diyaudioby/psl-3604/transformers/th-trans-psl-3604.JPG

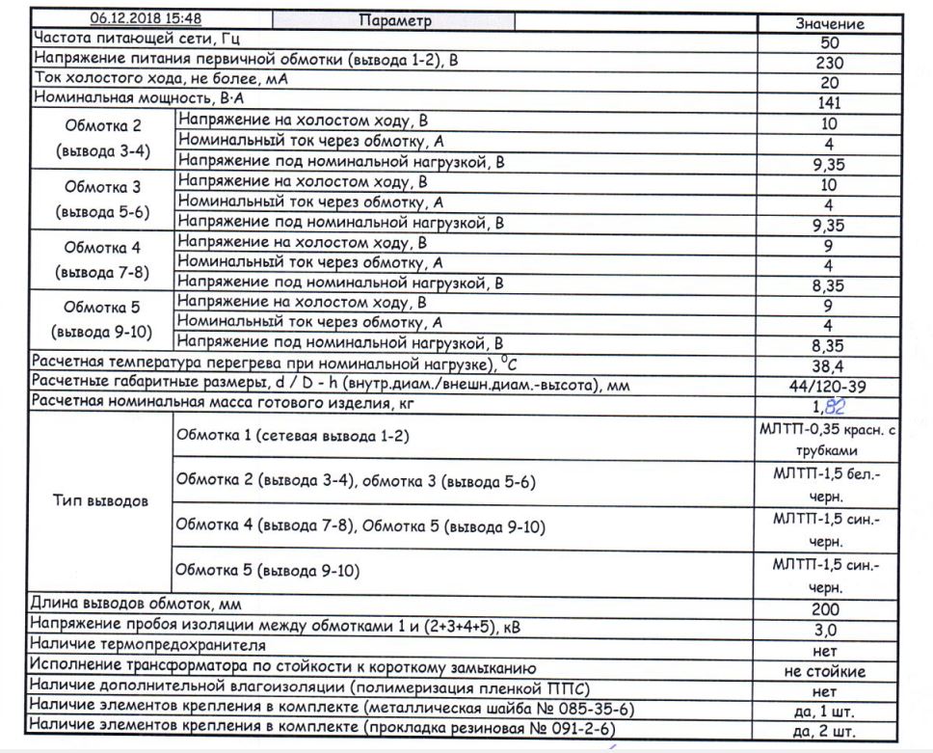
transformers/th-trans-psl-3604.JPG
