diyaudioby/psl-3604/bom/psl-3604-bom.xlsx

Таблица заказа комплектации PSL-3604 | ФИО |  |  | Комплектация | 1700.42
1. Сохранить таблицу (Файл - Скачать - Microsoft Excel) | Адрес доставки |  |  | Доставка
2. Проставить нужное количество деталек (столбец Е) либо удалить | Пункт выдачи заказа CDEK
3. Заполнить контактные данные | Телефон |  |  | Итого | 1700.42
4. Отправить на diyaudioby@gmail.com | Email
Позиция | Номинал | Доп. инфо | Кол-во | Цена, рос. руб | Сумма
Платы, трансформатор, корпус
Комплект плат |  |  | 1 | 700 | 700
Трансформатор |  |  | 1 |  |  | предзаказ - 1600р
Корпус Kradex Z2A |  |  | 1 |  |  | предзаказ - 400р
Конденсаторы SMD 0805
OUT: C33, C34 | 47p | NPO | 2
POW: C31 | 120p | NPO | 1
PAN: C2, C4 | 220p | NPO | 2
POW: C32, C39, C51 | 1n | NPO | 3
POW: C28, C29, C37, C38 | 2.2n | NPO | 4
OUT: C5 | 4.7n | X7R | 1
POW: C22 - C25, C35, C36, C40, C41, C42; PAN: C19; OUT: C14 | 10n | X7R | 11
OUT: C50 | 47n | X7R | 1
POW: C43 - C46; PAN: C1, C6, C9, C11 - C13, C15, C17, C18; OUT: C2, C6, C8, C15, C17 | 100n | X7R | 18
POW: C52; PAN: C3 | 1u | X7R | 2
Конденсаторы SMD 1206
OUT: C10 - C13 | 100n 100V | X7R 1210 | 4
Конденсаторы SMD танталовые
POW: C26, C27 | 1u 16V | Size A | 2
PAN: C8, C10, C14; OUT: C1, C3, C4, C7, C9, C16 | 22u 16V | Size B | 9
Конденсаторы электролитические выводные
POW: C4 - C9, C47, C48 | 47uF x 50V | d=6 | 8
POW: C1, C3 | 47uF x 100V | d=10 | 2
POW: C49 | 220uF x 25V | D=8 | 1
POW: C2 | 470uF x 35V | D=10 | 1
POW: C14, C19 | 1000uF x 35V | Samhwa SD (10*20) | 2
POW: C20 | 2200uF x 63V | Samhwa SD (18*31) | 1 | 40 | 40
POW: C21 | 3300uF x 50V | Samhwa SD (18*31) | 1 | 40 | 40
POW: C10 - C13, C15 - C18 | 10 000uF x 16V | Samhwa SD (16*31) | 8 | 40 | 320
Конденсаторы плёночные выводные
POW: C30 | 470n 63V | LS=5 (проверить) | 1
Резисторы SMD 0805 1% Yageo
POW: R68, R69; PAN: R41, R42 | 22R |  | 4
PAN: R29 | 49.9R |  | 1
PAN: R10 | 51R |  | 1
POW: R93, R94; PAN: R2, R5, R12 - R27, R35 - R39, R50; OUT: R14, R17 | 100R |  | 27
OUT: R30 | 120R |  | 1
POW: R45, R46, R52, R54; OUT: R5, R8, R9 | 220R |  | 7
OUT: R2, R15 | 270R |  | 2
POW: R77, R83, R86; PAN: R3, R4, R45 | 330R |  | 6
OUT: R31 | 360R |  | 1
POW: R65, R66, R90; PAN: R30 - R32, R40; OUT: R12, R13 | 470R |  | 9
POW: R84, R85 | 750R |  | 2
OUT: R3, R16 | 820R |  | 2
POW: R95; PAN: R8, R33, R34; OUT: R7 | 1k |  | 5
PAN: R28; OUT: R6 | 1.5k |  | 2
POW: R47, R48, R51, R53, R55, R56, R96; OUT: R18 - R24 | 2.2k |  | 14
POW: R49, R83 | 3.3k |  | 2
POW: R9-R16, R25-R32, R34-R37, R73, R74, R88, R97; PAN: R1, R9, R11, R43, R44, R46-R48; OUT: R1 | 4.7k |  | 33
POW: R89 | 5.1k |  | 1
POW: R1 - R8, R17 - R24, R33, R38, R75, R76, R81, R91, R98; OUT: R4, R11 | 10k |  | 25
OUT: R10 | 27k |  | 1
POW: R40, R42 - R44, R79, R87, R92; PAN: R6, R7, R49; OUT: R32 | 47k |  | 11
OUT: R33 | 1M |  | 1
Резисторы SMD 1206
POW: R50 | 1R |  | 1
Резисторы SMD 2512
OUT: R25 - R28 | 0.1R |  | 8
OUT: R29 | 2.2R |  | 1
Резисторы выводные 0.125Вт 0.1%
POW: R57, R58, R63, R64 | 10k | С2-29-0,125-10К-0,1%-А | 4 | 20 | 80
POW: R70, R71 | 20k | С2-29-0,125-20К-0,1%-А | 2 | 20 | 40
POW: R59 - R62 | 100k | С2-29-0,125-100К-0,1%-А | 4 | 20 | 80
Резисторы выводные 2Вт 1%
POW: R67, R72 | 0.15R | С5-16МВ-2-0,15R 1% | 2
Индуктивности, дросселя
PAN: L1, L3 | BLM21PG600SN1D | 60 Ohms 3А, 0805 | 2
POW: L1 | RCH895NP-471K | 8 x 8 x 10 мм | 1
Диоды, стабилитроны
POW: VD25 | SS16 | DO-214AA | 1
POW: VD11 | MB10S | SOIC-4W | 1
POW: VD1 - VD6, VD18, VD19, VD21, VD23, VD24, VD26; PAN: VD1 - VD3; OUT: VD1 - VD4, VD6 - VD10 | BAS316 | SOD-323 | 23
POW: VD7 - VD10, VD12 - VD15; OUT: VD11 | BZV55C15 | 15V 0.5W, miniMELF | 9
OUT: VD5 | BZV55C6V8 | 6.8V 0.5W, miniMELF | 1
POW: VD16, VD17 | ES1D | DO-214AC | 2
PAN: VD5, VD6 | GNL-3014ED | 3mm, Red | 2
PAN: VD4 | GNL-3014GD | 3mm, Green | 1
PAN: VD7 | GNL-3014YD | 3mm, Yellow | 1
OUT: VD12 - VD14 | MBR20100CT | TO-220 | 3 | 30 | 90
POW: VD22 | P6KE47 | DO-15 | 1
PAN: HG1 | FYQ-3641AG-11 | Green | 1
PAN: HG2 | FYQ-3641AHR-11 | Red | 1
Транзисторы
PAN: VT2,VT3; OUT: VT1,VT6,VT9 | BC847C | SOT-23 | 5
POW: VT15; PAN: VT1; OUT: VT10 | BC857C | SOT-23 | 3
POW: VT11; OUT: VT2, VT3, VT5 | MMBT5401LT | SOT-23 | 4
VT4 - OUT; VT9,VT10,VT12,VT13 - POW | MMBT5551LT | SOT-23 | 5
OUT: VT7, VT8 | BCP56 | SOT-223 | 2
POW: VT1 - VT8 | IRFR4105ZPBF | DPak | 8
OUT: VT11-VT14 | IRF540N | TO-220 | 4 | 25 | 100
OUT: VT15 | IRF9Z34 | TO-220 | 1
POW: VT15 | IRLML2803 | TO-220 | 1
Микросхемы
PAN: U1 | STM32F100C8T6B | LQFP-48 | 1
OUT: U3 | TL431CDBZ | SOT-23 | 1
OUT: U6 | FT232RL | SSOP-28 | 1
PAN: U2 - U4 | 74HCT595D | SOIC-16 | 3
PAN: U6 | ULN2003D | SOIC-16 | 1
POW: U10 | LM358D | SOIC-8 | 1
POW: U1 - U6 | LM393D | SOIC-8 | 6
PAN: U5 | LP2951ACM-3.3 | SOIC-8 | 1
PAN: U10 | AT24C04 | SOIC-8 | 1
POW: U7 - U9, U11 | TL082CD | SOIC-8 | 4
PAN: U8, U9 | PS2701-1 | SOIC-4W | 2
OUT: U1 | DS18B20 | TO-92 | 1
OUT: U4 | LM317LZ | TO-92 | 1
OUT: U2 | LM337LZ | TO-92 | 1
OUT: U5 | LD1086V | TO-220 | 1
Пьезоизлучатели, энкодеры, механика
HS1 | HC0903A |  | 1
PAN | PEC16-4220F-S0024S |  | 1
PAN: SB1, SB2 | DTSM-6 (KAN0611) | Tact Switch 6x6x4 | 2
PAN: SB3 - SB6 | DTSM-6 (KAN0611) | Tact Switch 6x6x15 | 4
Изолирующая силиконовая прокладка TO-3P 20мм x 26мм | bushing TO-3P (https://photos.app.goo.gl/HZ2XKzNtsUhnp4JJ7) |  | 9 | 3 | 27
Изолирующая втулка TO-220 | bushing TO-220 (https://photos.app.goo.gl/JnYvL1F9MbzPJiJf6) |  | 9 | 0.3 | 2.7
Разъёмы
POW: XP2, XP4; PAN: XP4; OUT: XP1 | IDC-10F (https://www.chipdip.ru/product/idc-10f?from=rec_product) |  | 4 | 5 | 20
XP1 - OUT; XP4 - PAN; XP2,XP4 - POW | IDC-10MS (https://www.chipdip.ru/product/idc-10ms) |  | 4 | 5 | 20
POW: XP6; PAN: XP5 | PLS-1 (https://www.chipdip.by/product/pls-4) | Гребёнка 1pin (https://www.chipdip.by/product/pls-4) | 2 | 0.3 | 0.6
PAN: XP3 | PLS-4 (https://www.chipdip.by/product/pls-4) | Гребёнка 4pin (https://www.chipdip.by/product/pls-4) | 1 | 0.12 | 0.12
XP1 - PAN; XP1,XP3,XP5 - POW | PW-2 (W-02, CFW-02) | папа + мама | 4
XP2 - OUT; XP2 - PAN; | PW-4 (W-04, CFW-04) | папа + мама | 2
XT1-XT9 - OUT; XT1 - XT19 - POW | KLS8-01128-PC250 | папа + мама + изолятор | 28 | 5 | 140
OUT: XS1 | USBB-1J |  | 1
