diyaudioby/psl-3604/docs/psl-3604_front_versions.pdf

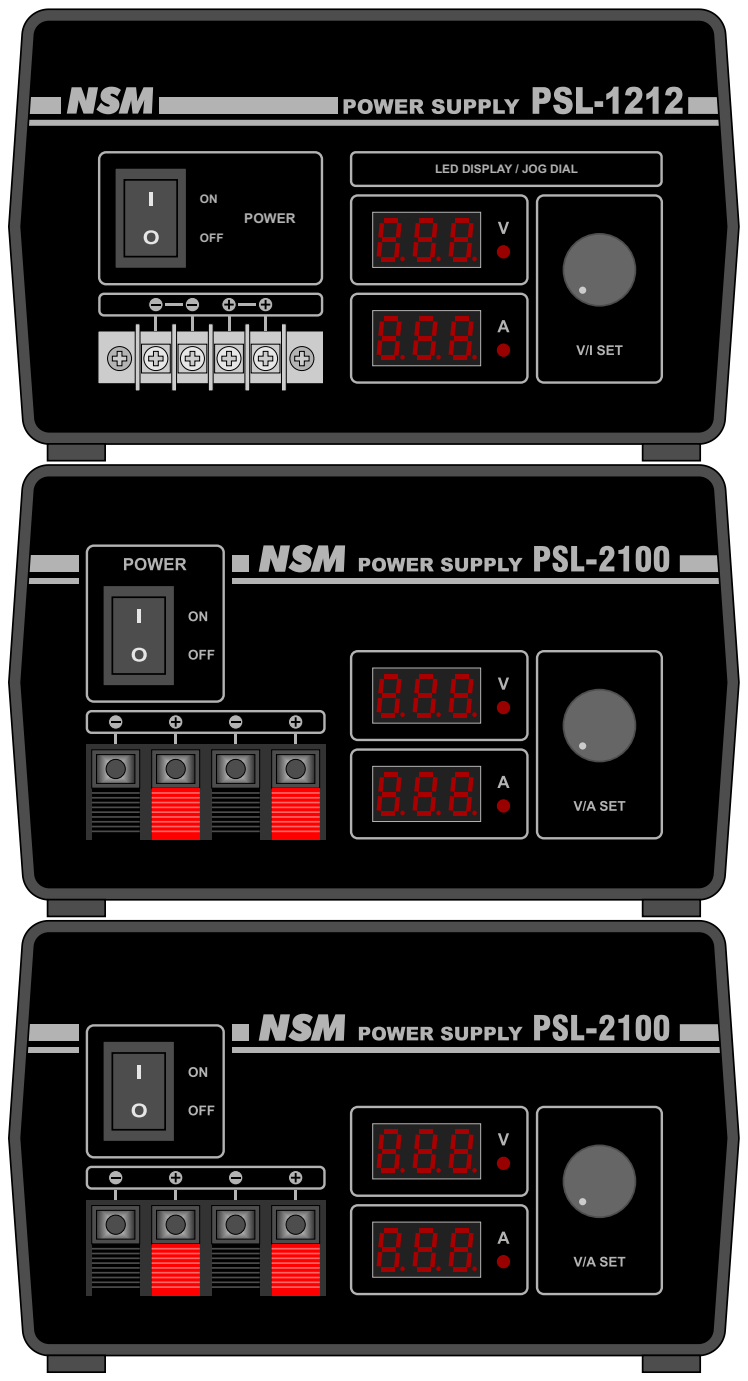
[picture p80: page 1]
POWER; OFF

LED DISPLAY / JOG DIAL

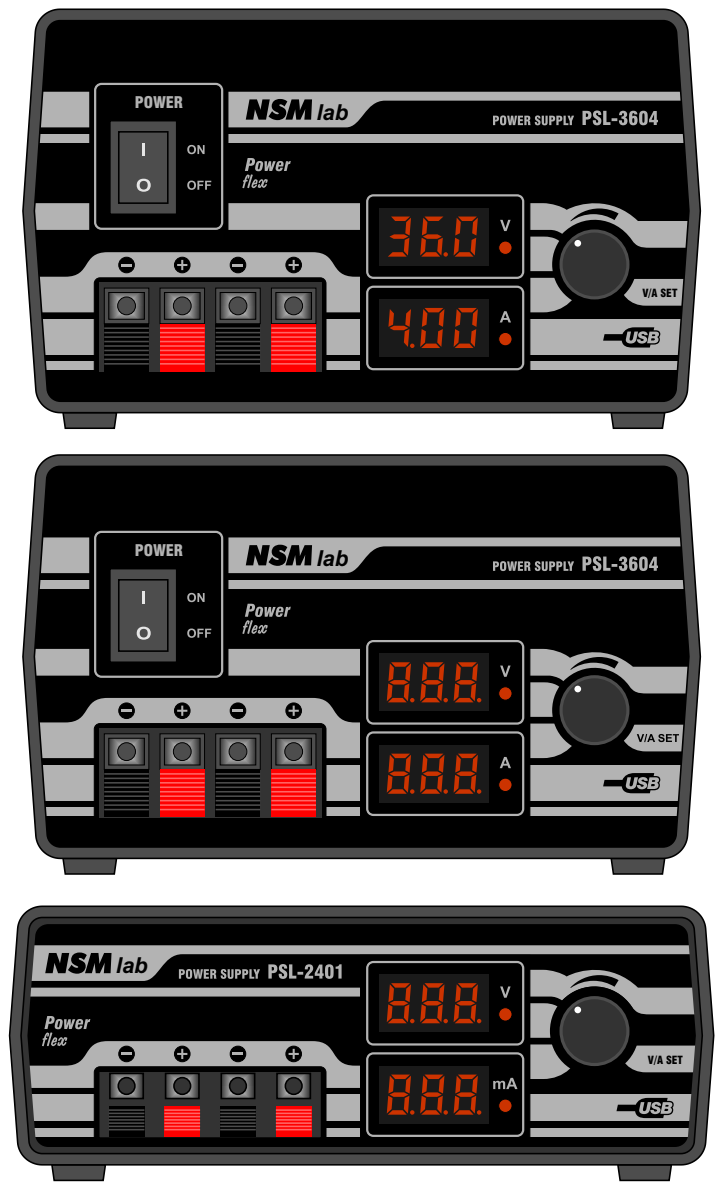
[picture p81: page 2]
lab POWER; V/A SET; lab

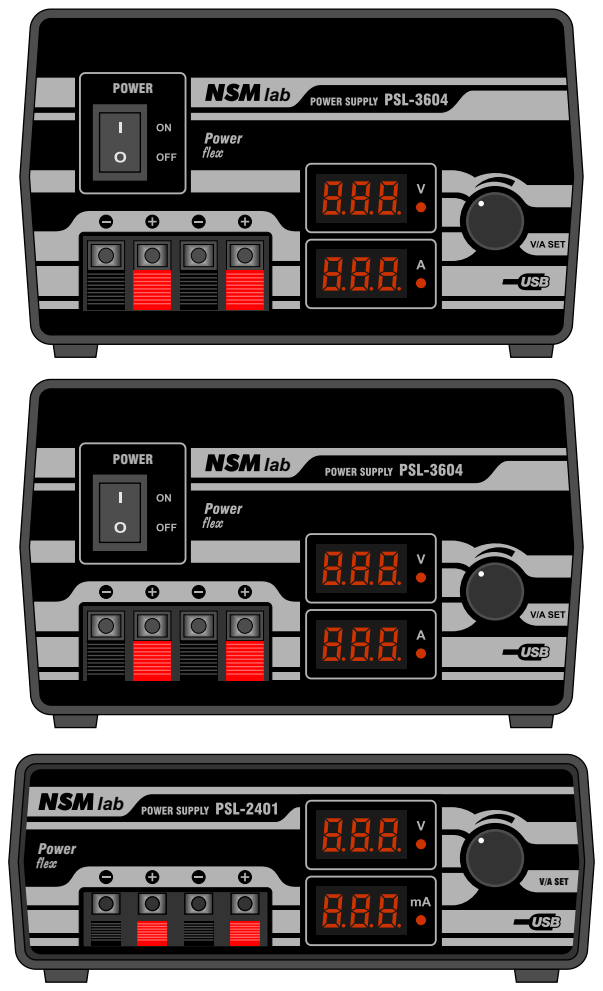
[picture p82: page 3]
lab POWER; V/A SET; lab; Power flex

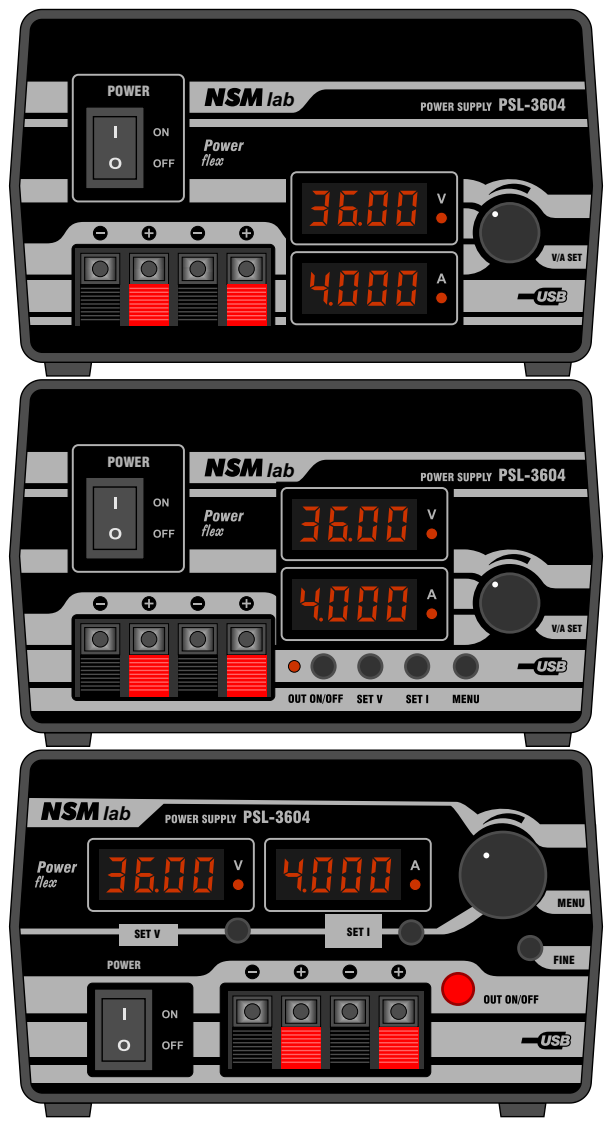
[picture p83: page 4]
V/A SET; lab; POWER; FINE; MENU; SET V; SET I

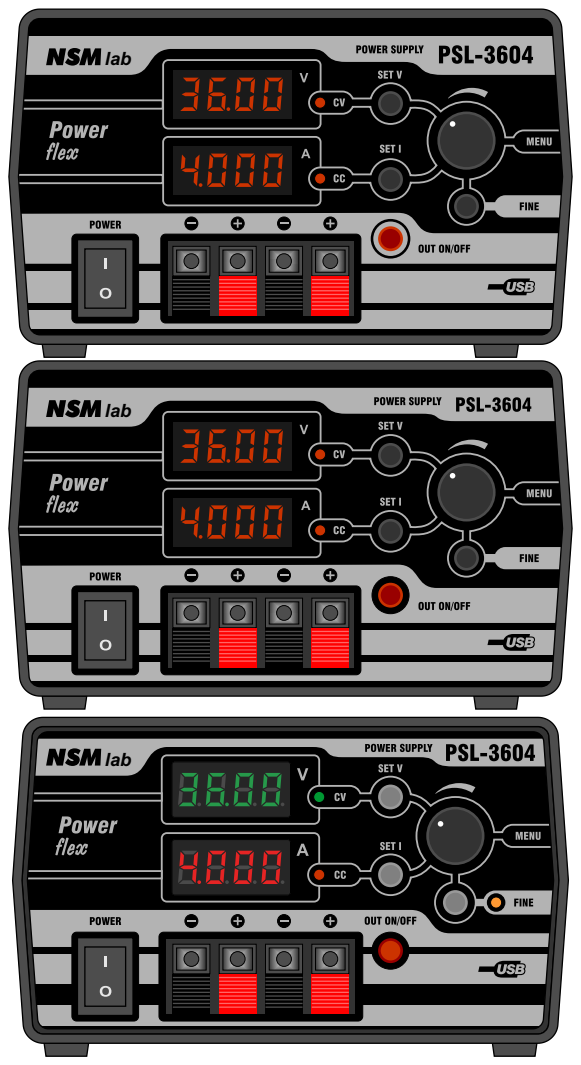
[picture p84: page 5]
lab

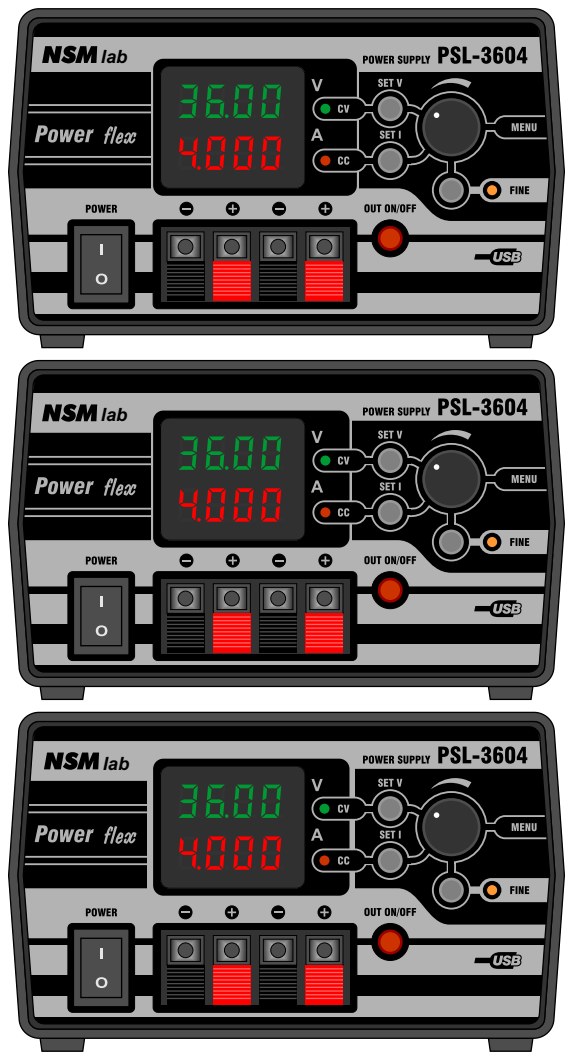
[picture p85: page 6]
lab

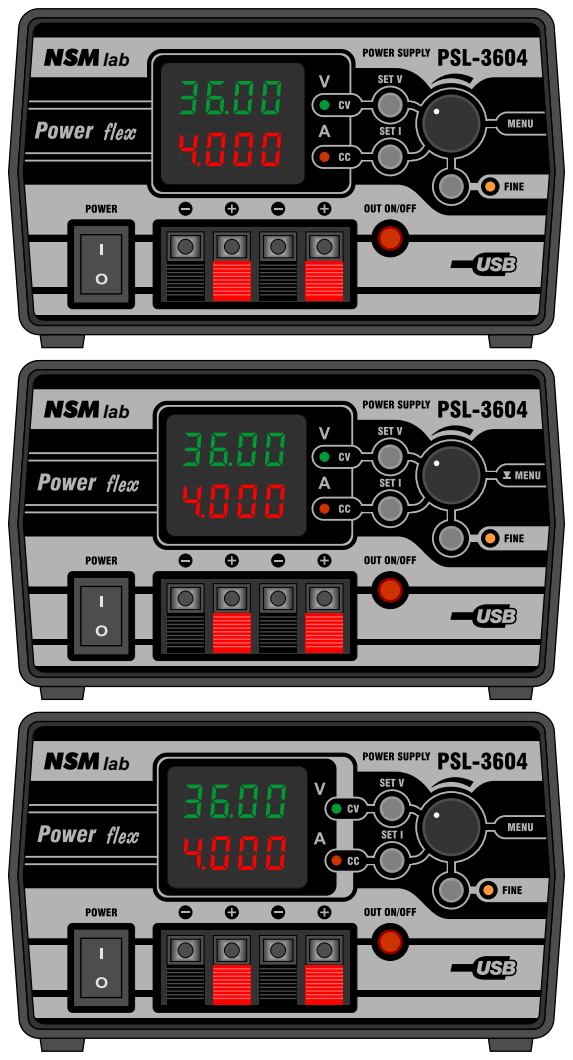
[picture p86: page 7]
lab

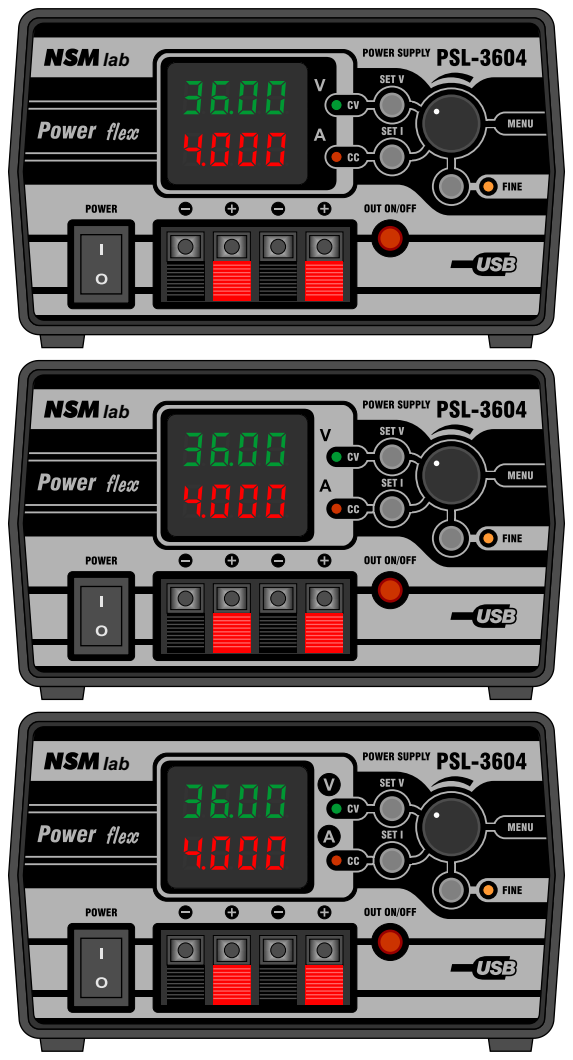
[picture p87: page 8]
lab

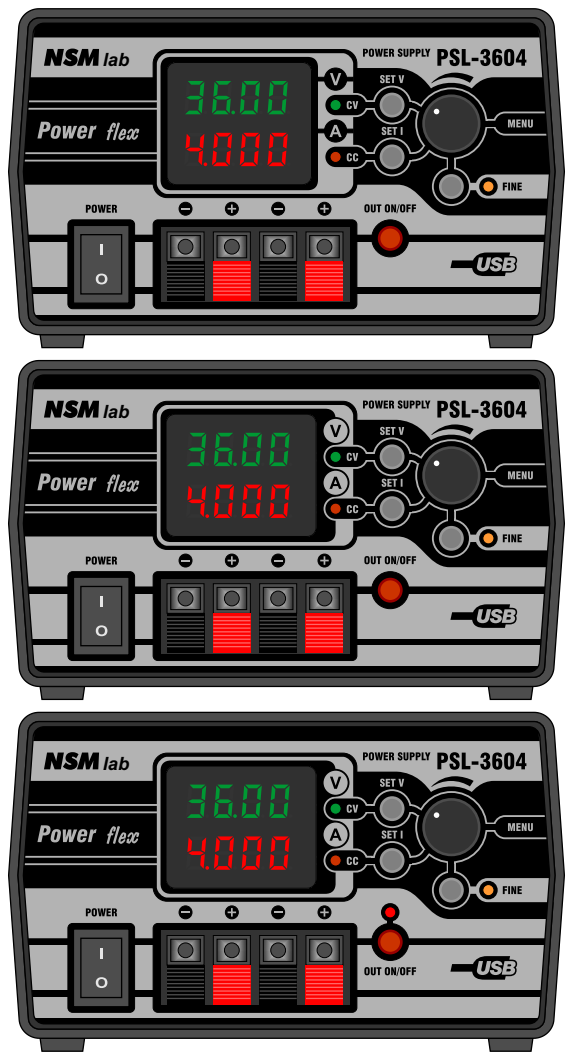
[picture p88: page 9]
lab

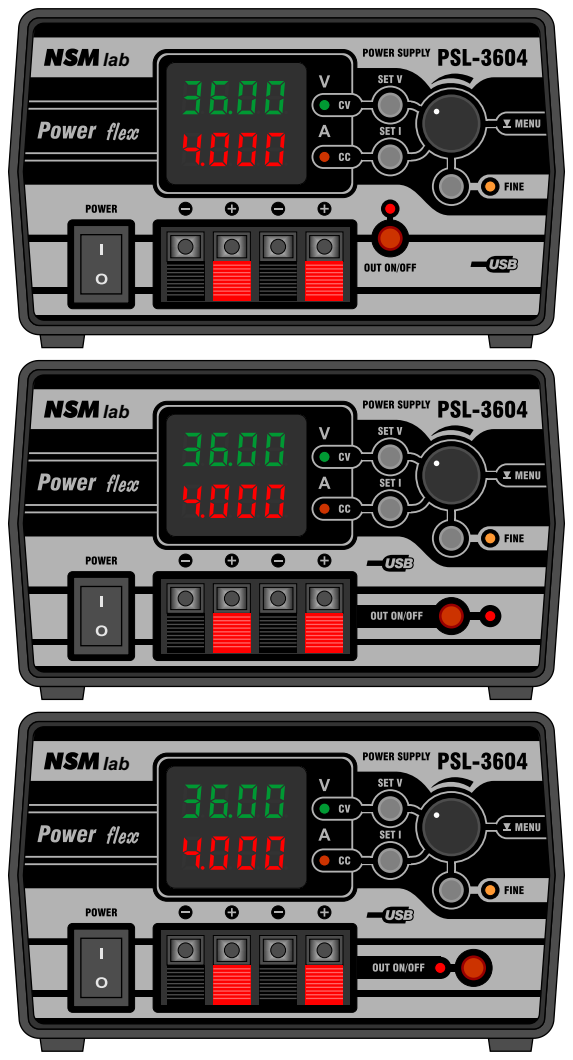
[picture p89: page 10]
lab

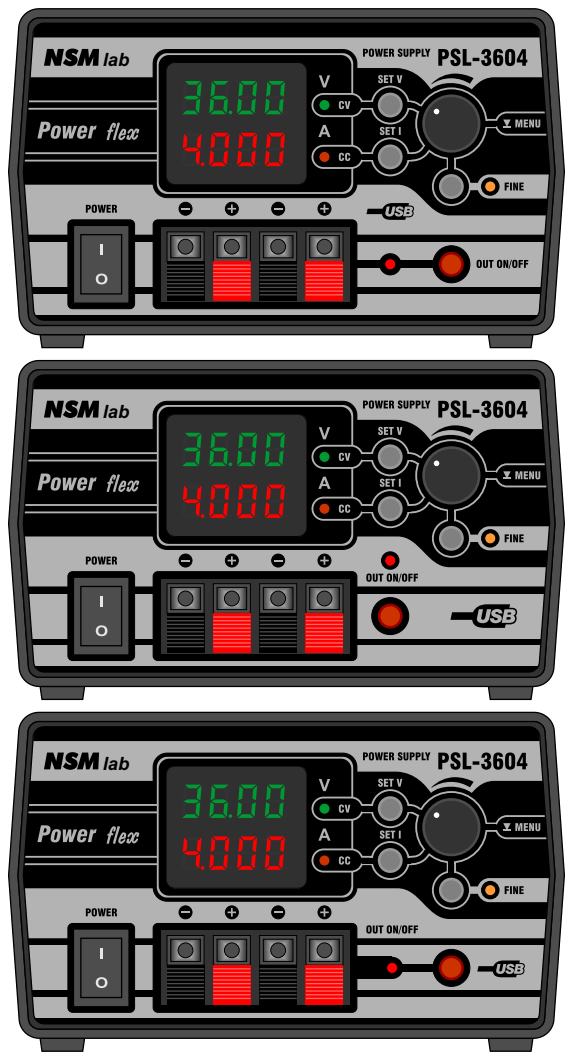
[picture p90: page 11]
lab

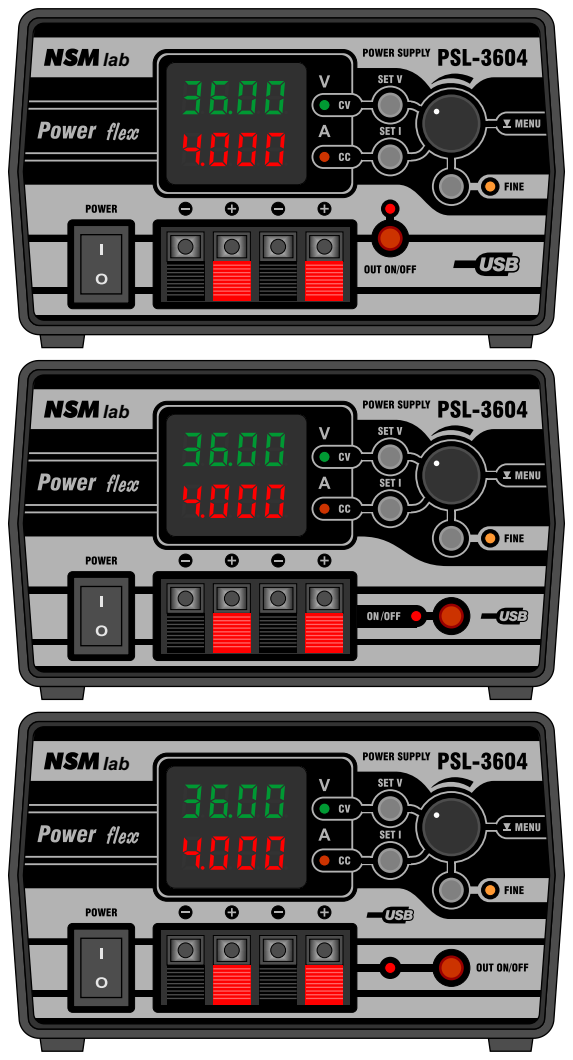
[picture p91: page 12]
lab

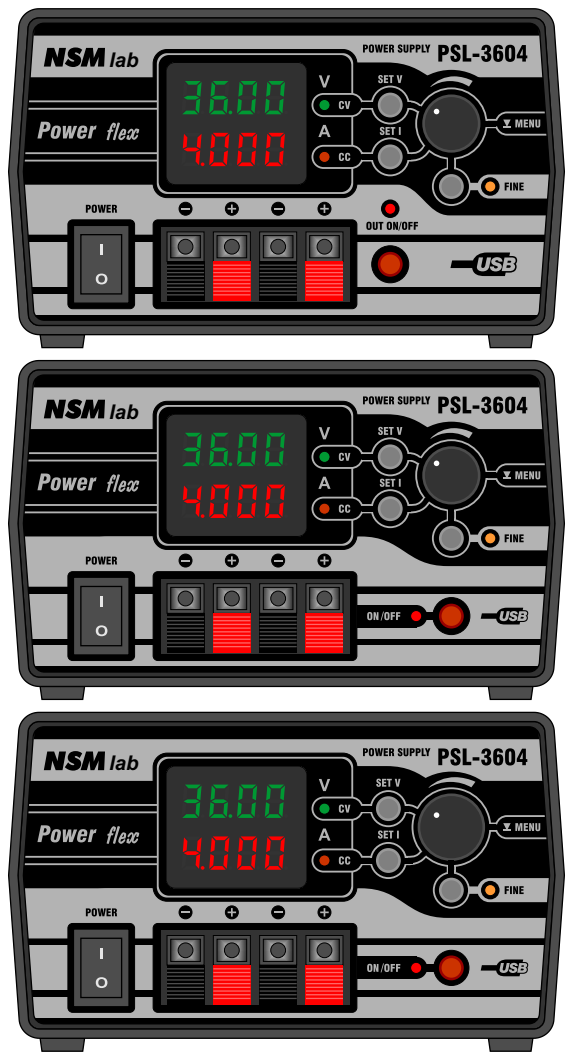
[picture p92: page 13]
lab

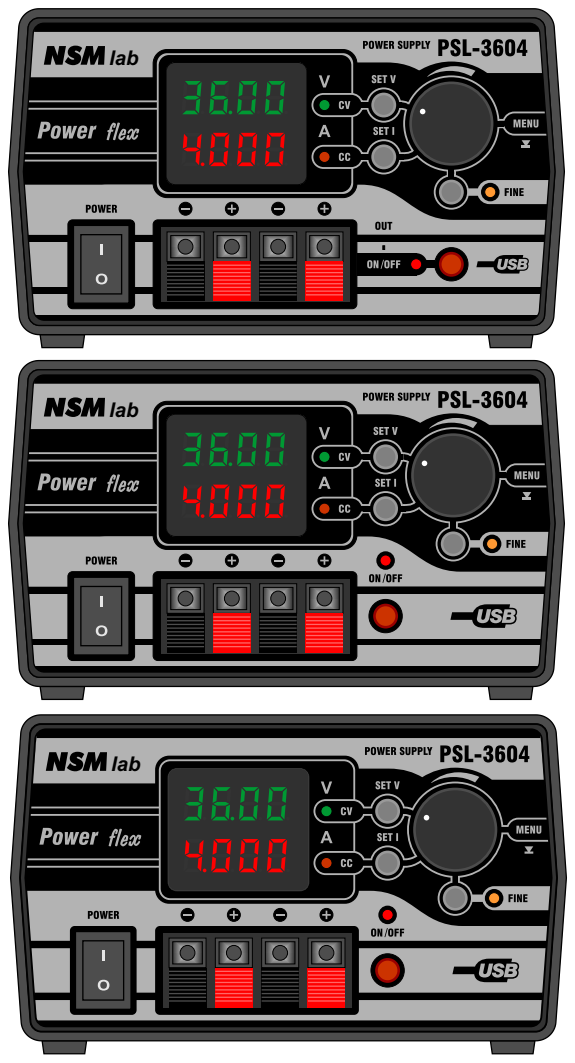
[picture p93: page 14]
lab

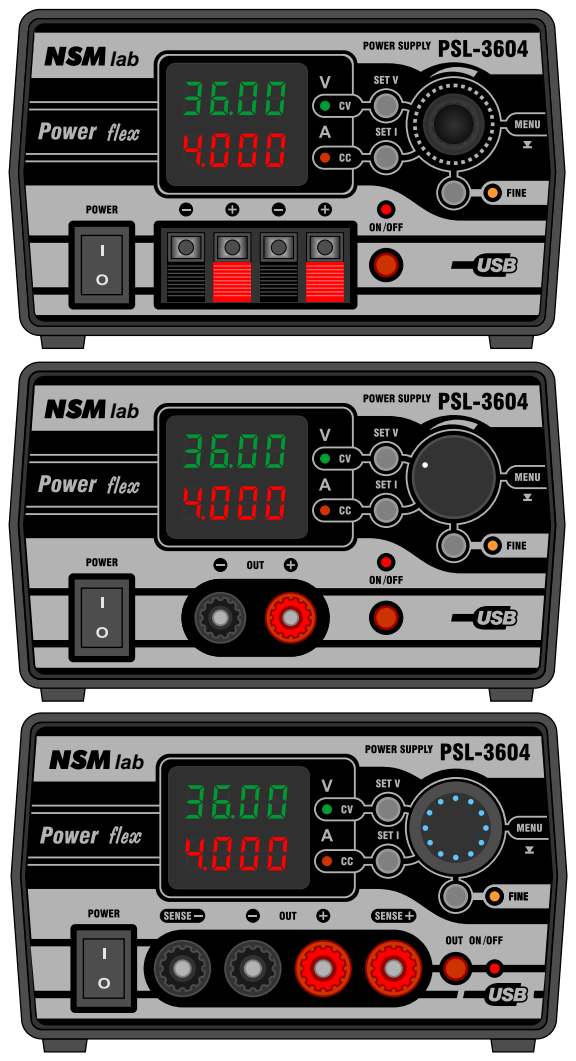
[picture p94: page 15]
lab
