diyaudioby/psl-3604/docs/psl-3604_comp.pdf

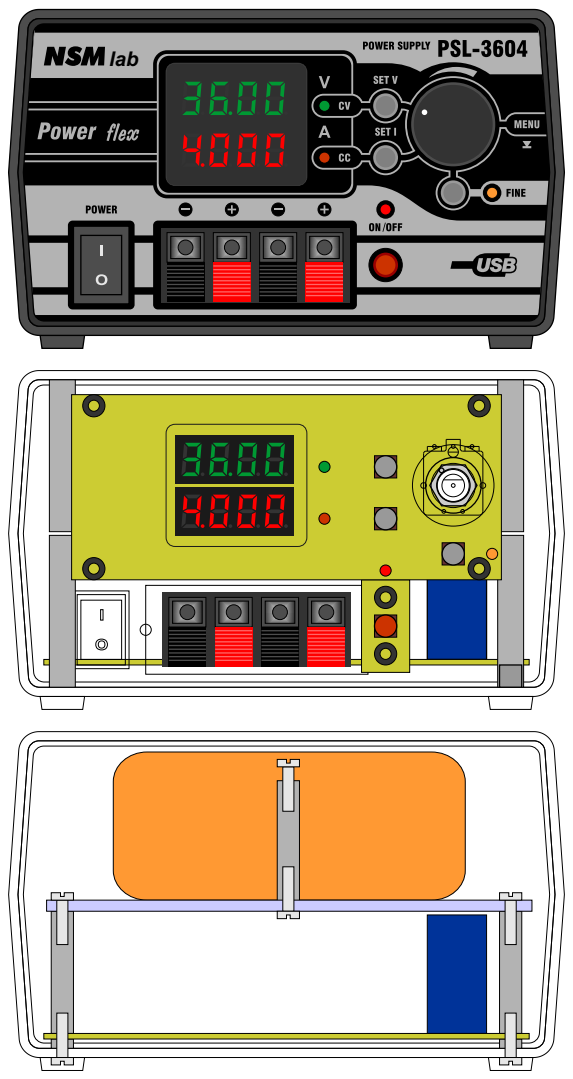
[picture p95: page 1]
lab

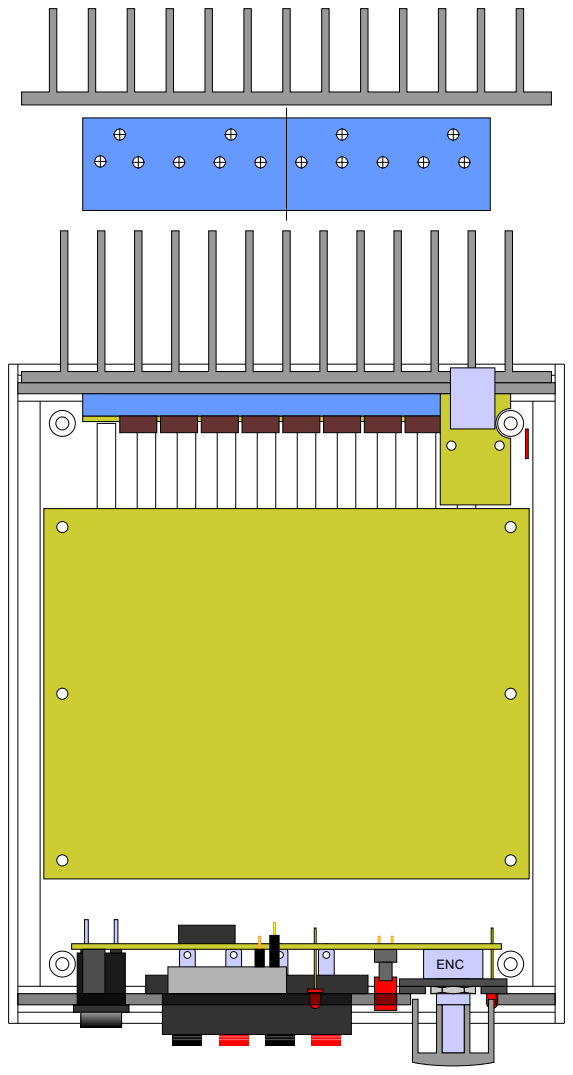
[picture p96: page 2]
ENC

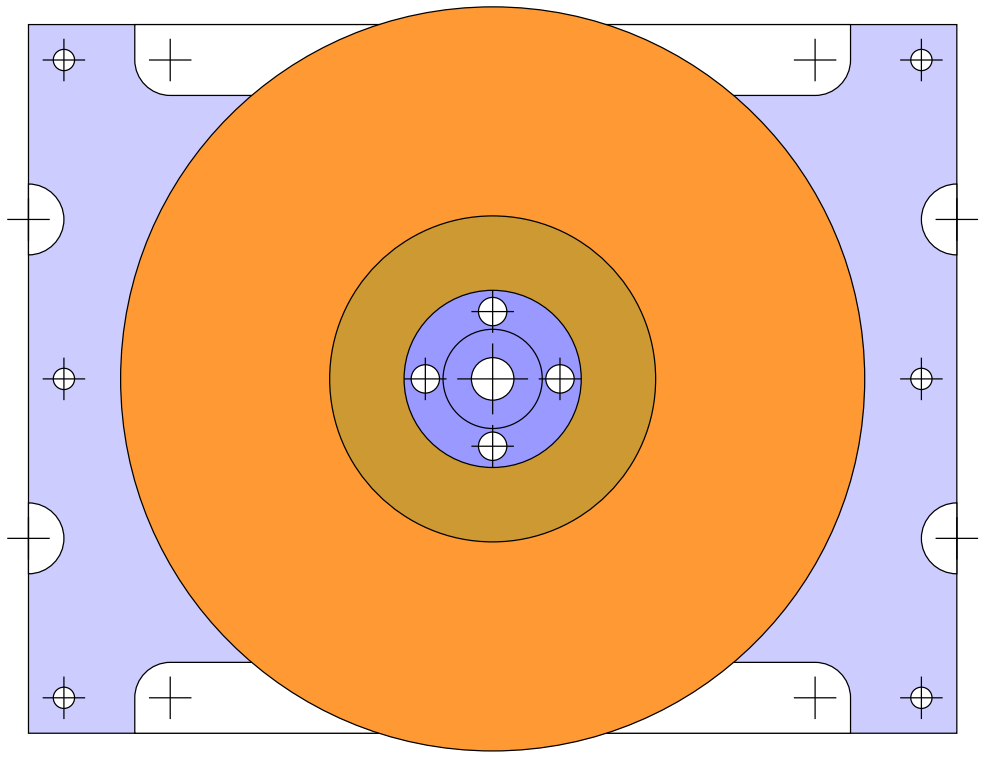
[picture p97: figure]
