diyaudioby/psl-3604/docs/psl-3604_model.pdf

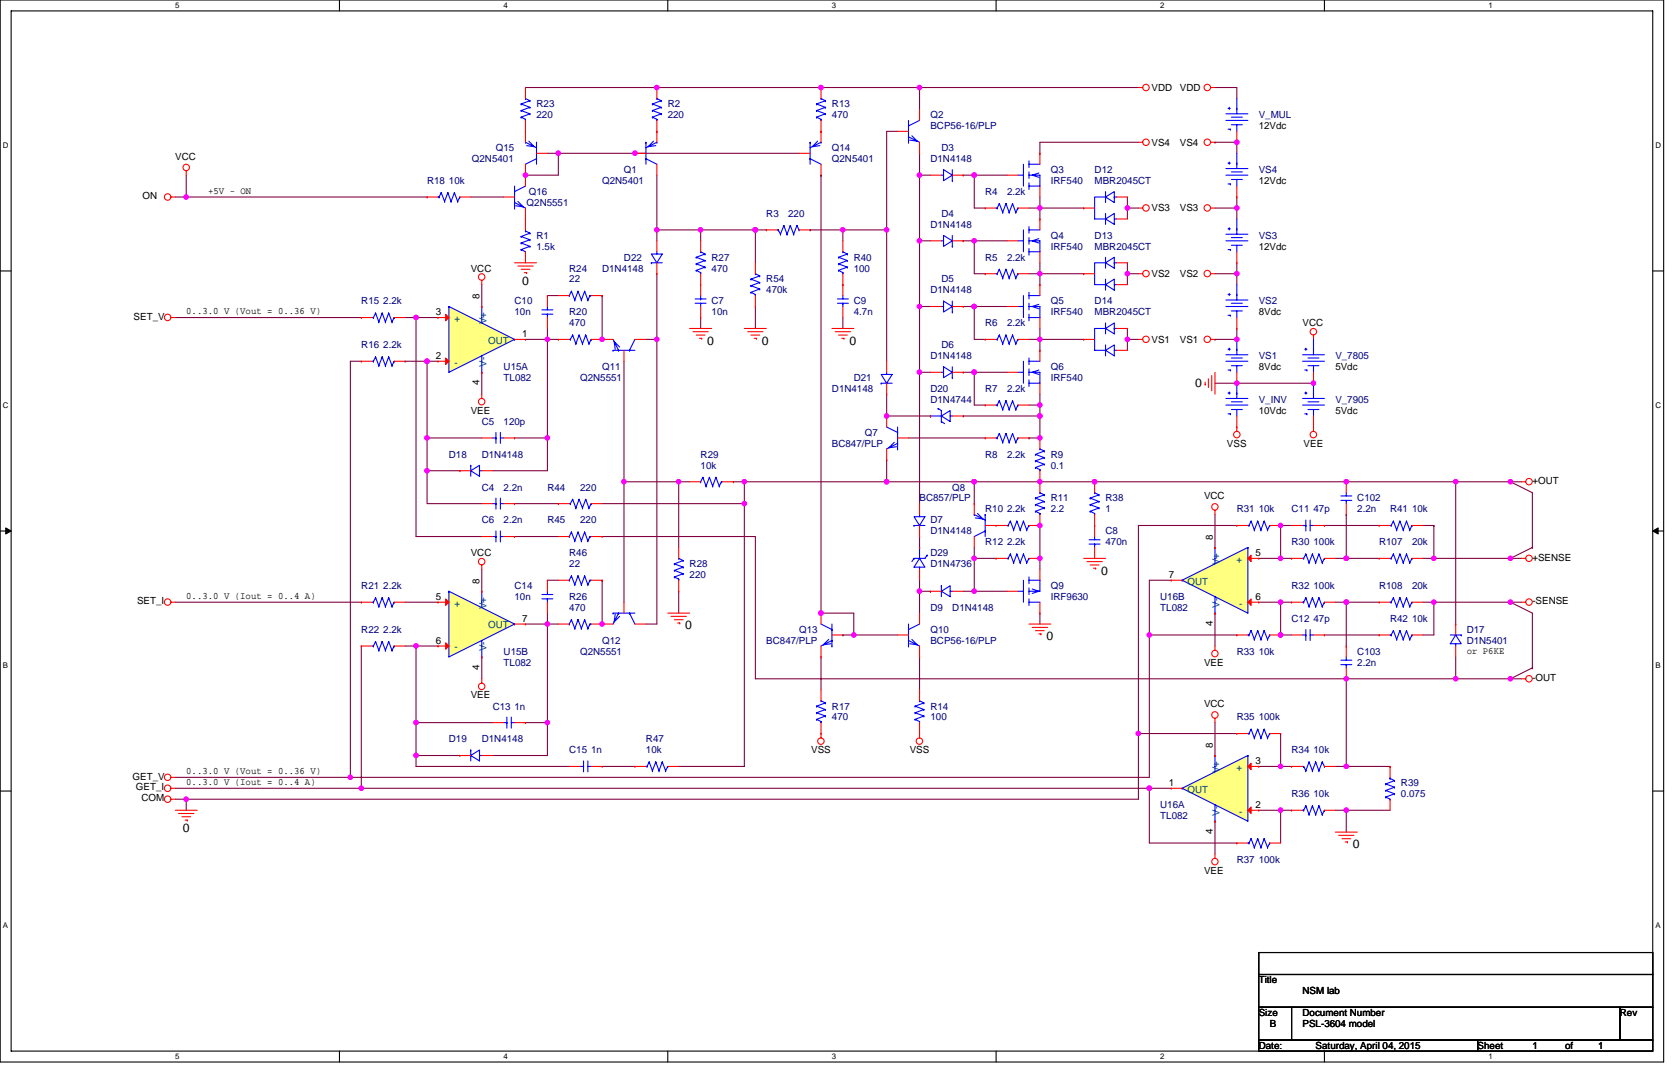
[picture p98: page 1]

Size Size Size B B B | Document Number Document Number Document Number PSL-3604 model PSL-3604 model PSL-3604 model | Rev Rev Rev

Date: Date: Date: Saturday, April 04, 2015 Saturday, April 04, 2015 Saturday, April 04, 2015 | Sheet Sheet Sheet 1 1 1 of of of 1 1 1
