diyaudioby/psl-3604/docs/psl-3604_sch.pdf

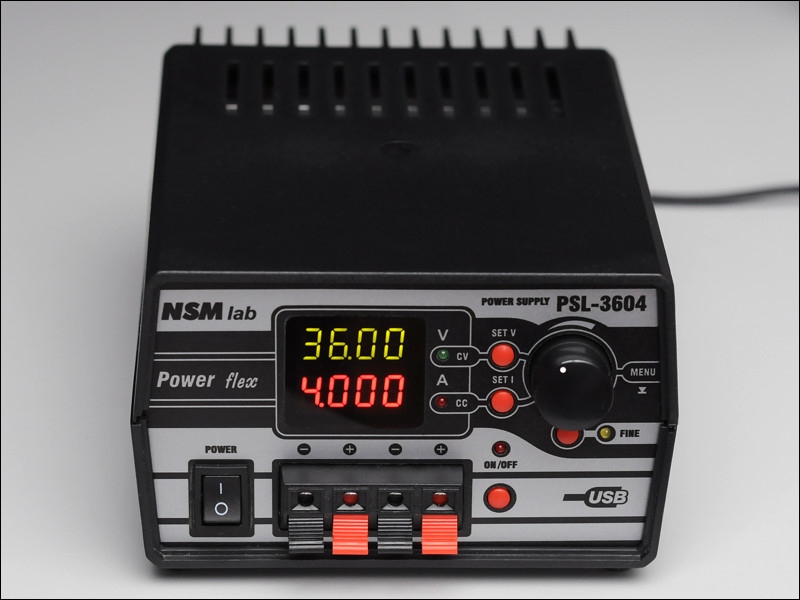
[picture p105: page 1]

Size Size Size B B B | Document Number Document Number Document Number PSL-3604 model PSL-3604 model PSL-3604 model | Rev Rev Rev

Date: Date: Date: Saturday, April 04, 2015 Saturday, April 04, 2015 Saturday, April 04, 2015 | Sheet Sheet Sheet 1 1 1 of of of 1 1 1

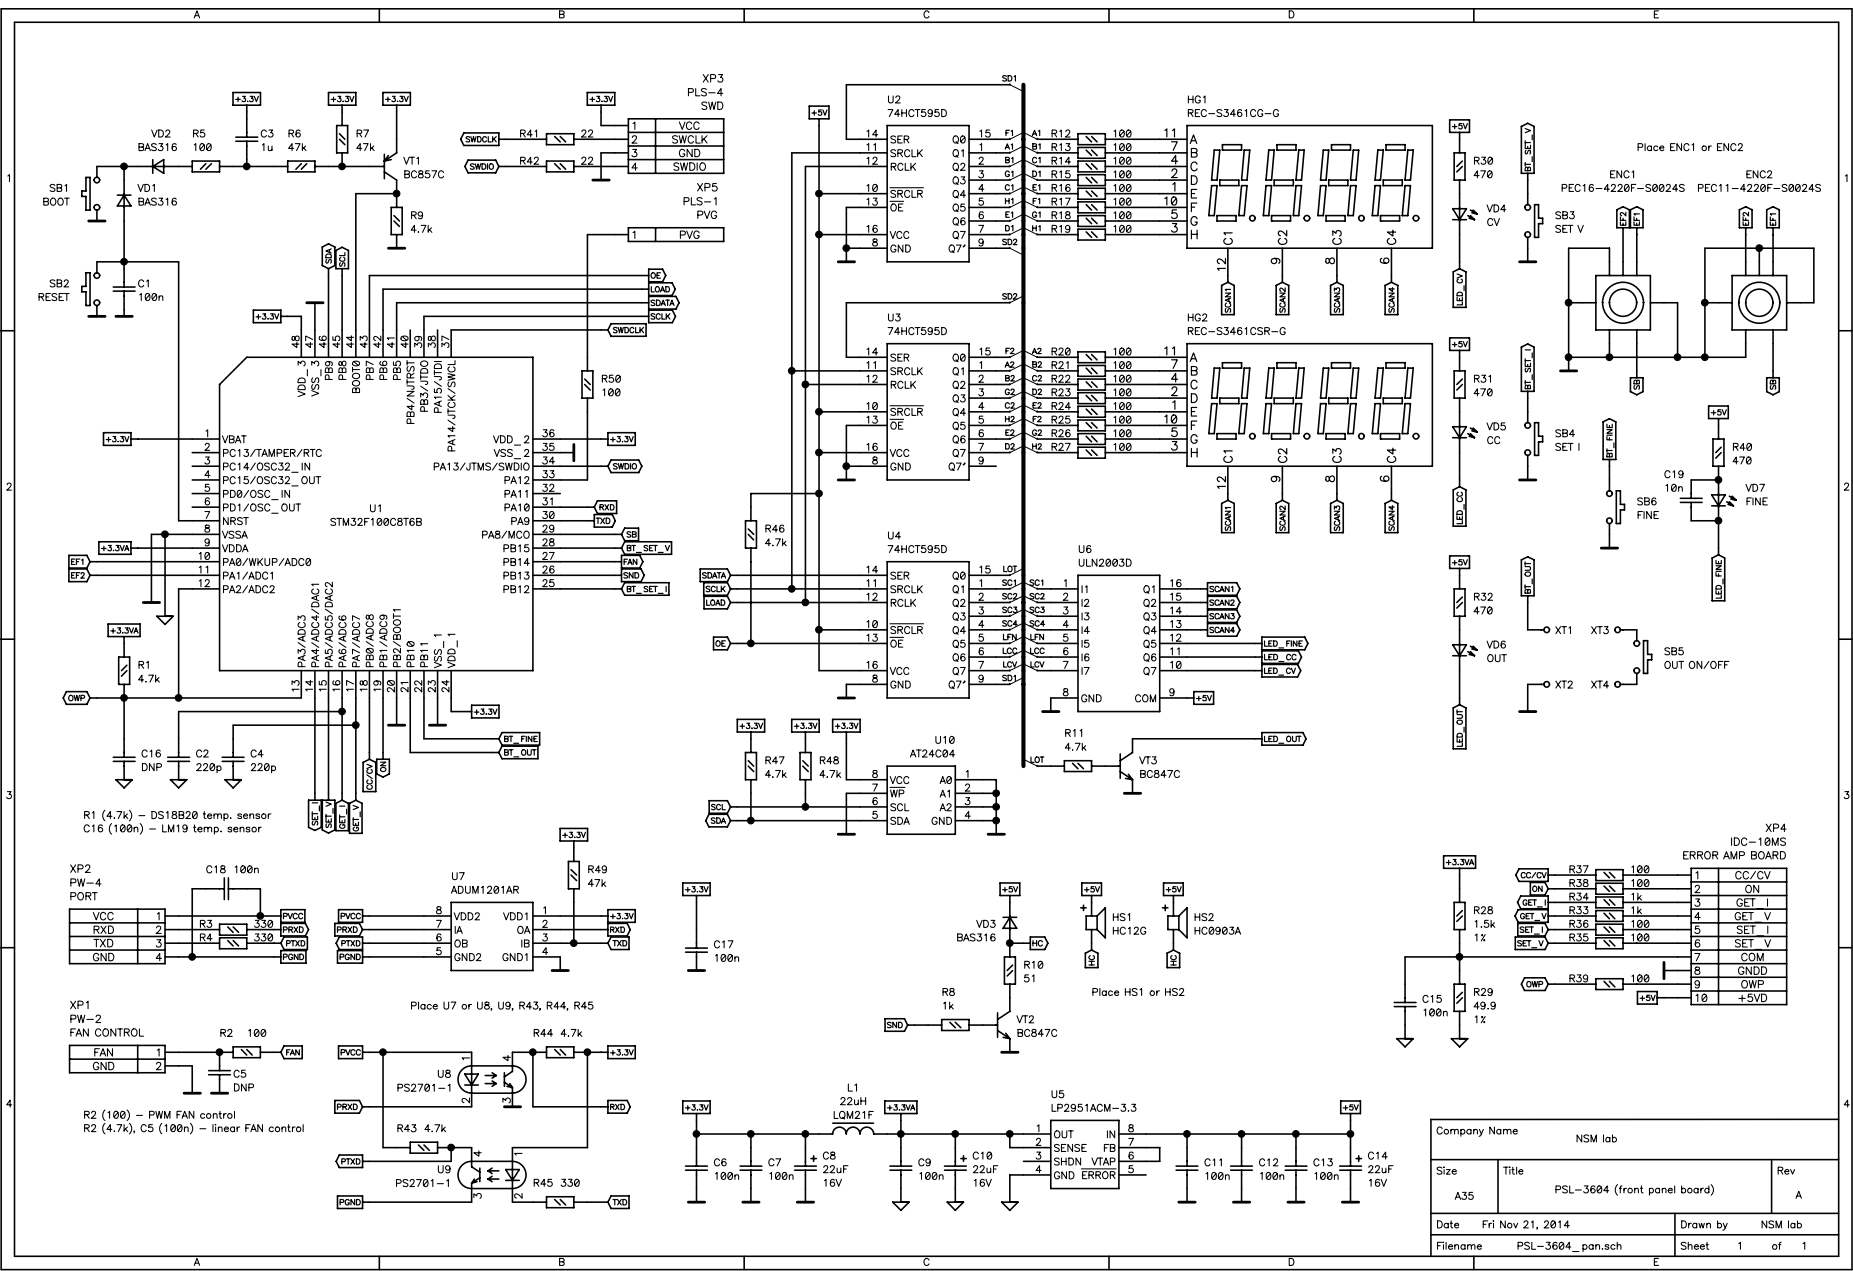
[picture p106: page 3]

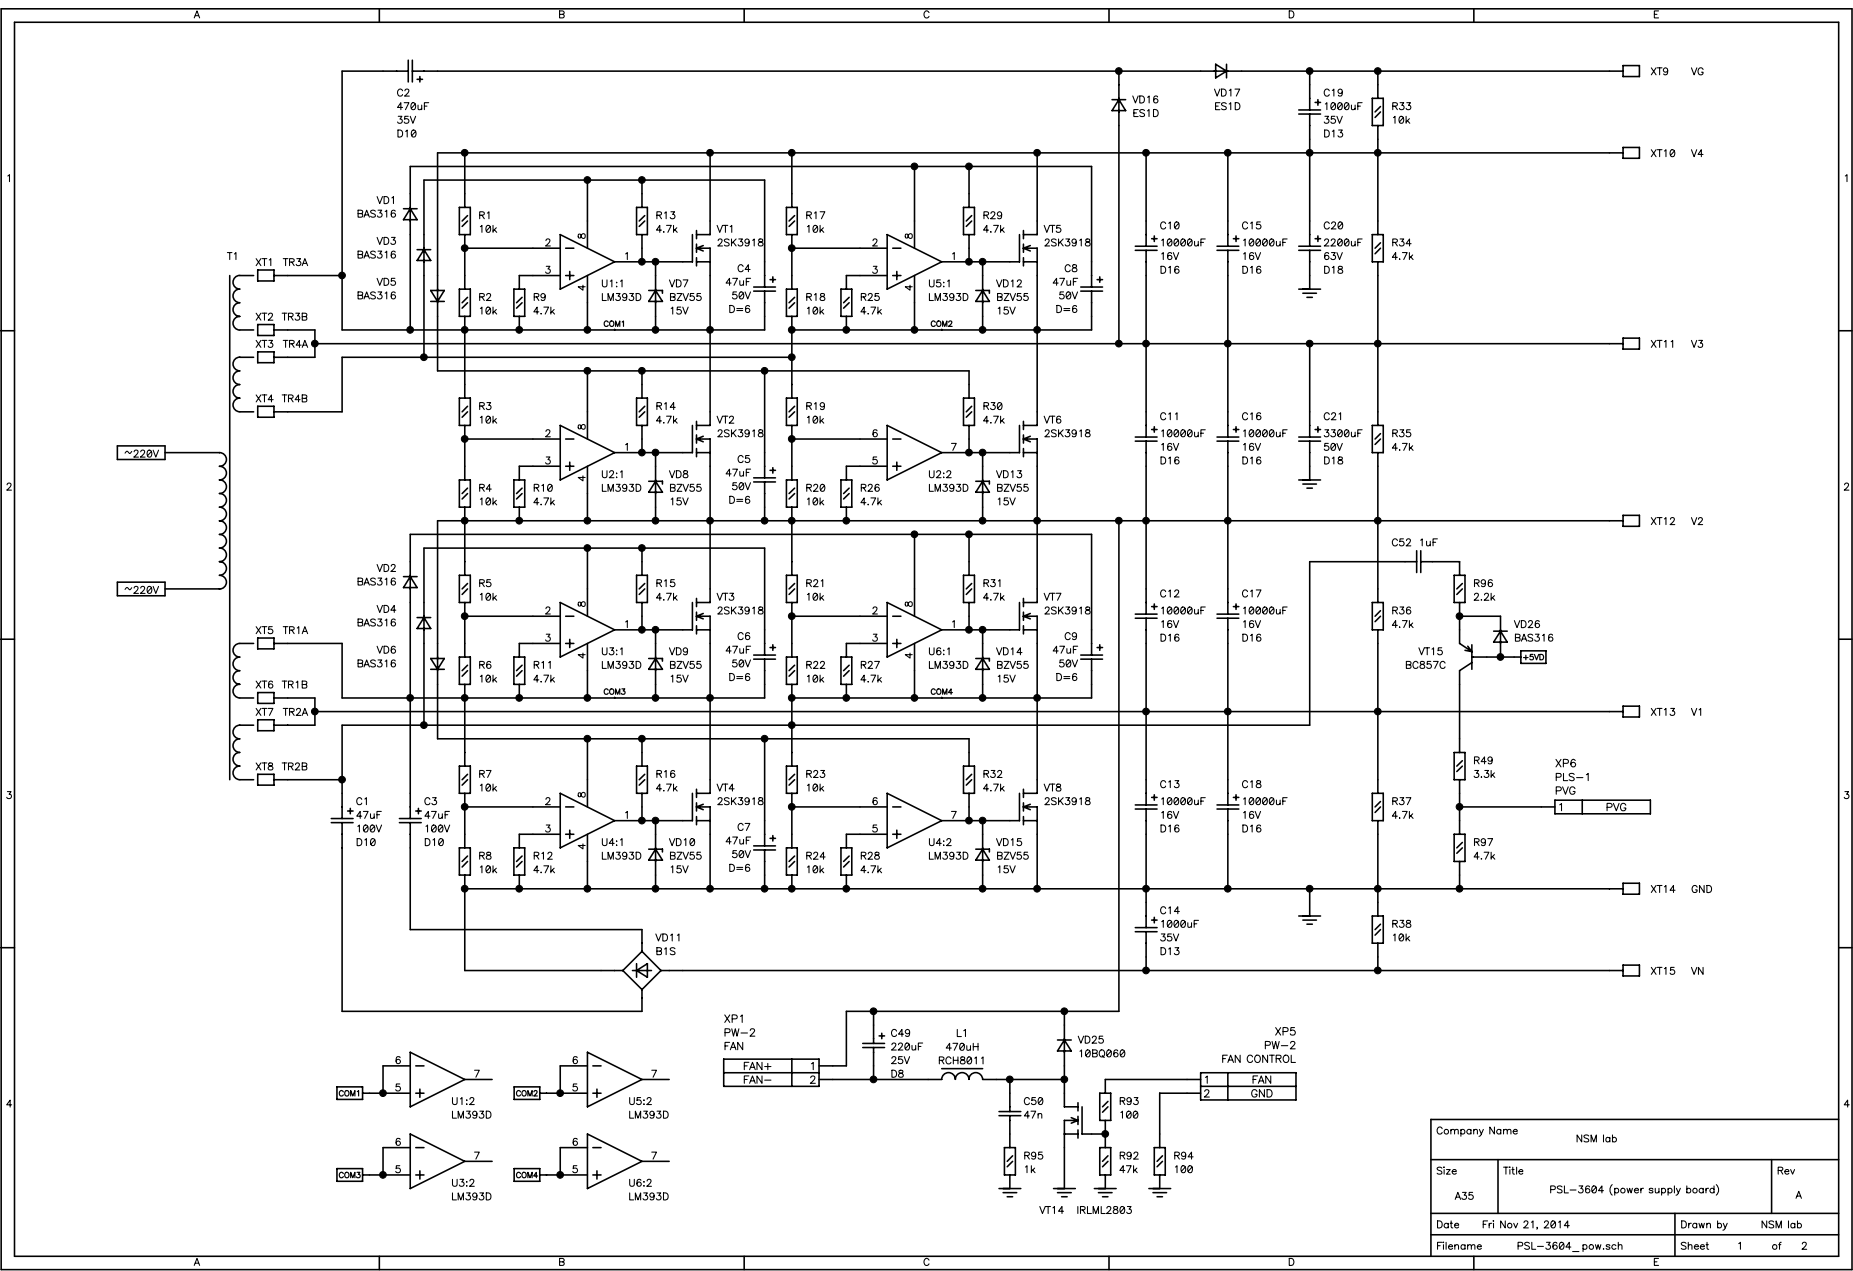
[picture p107: page 4]

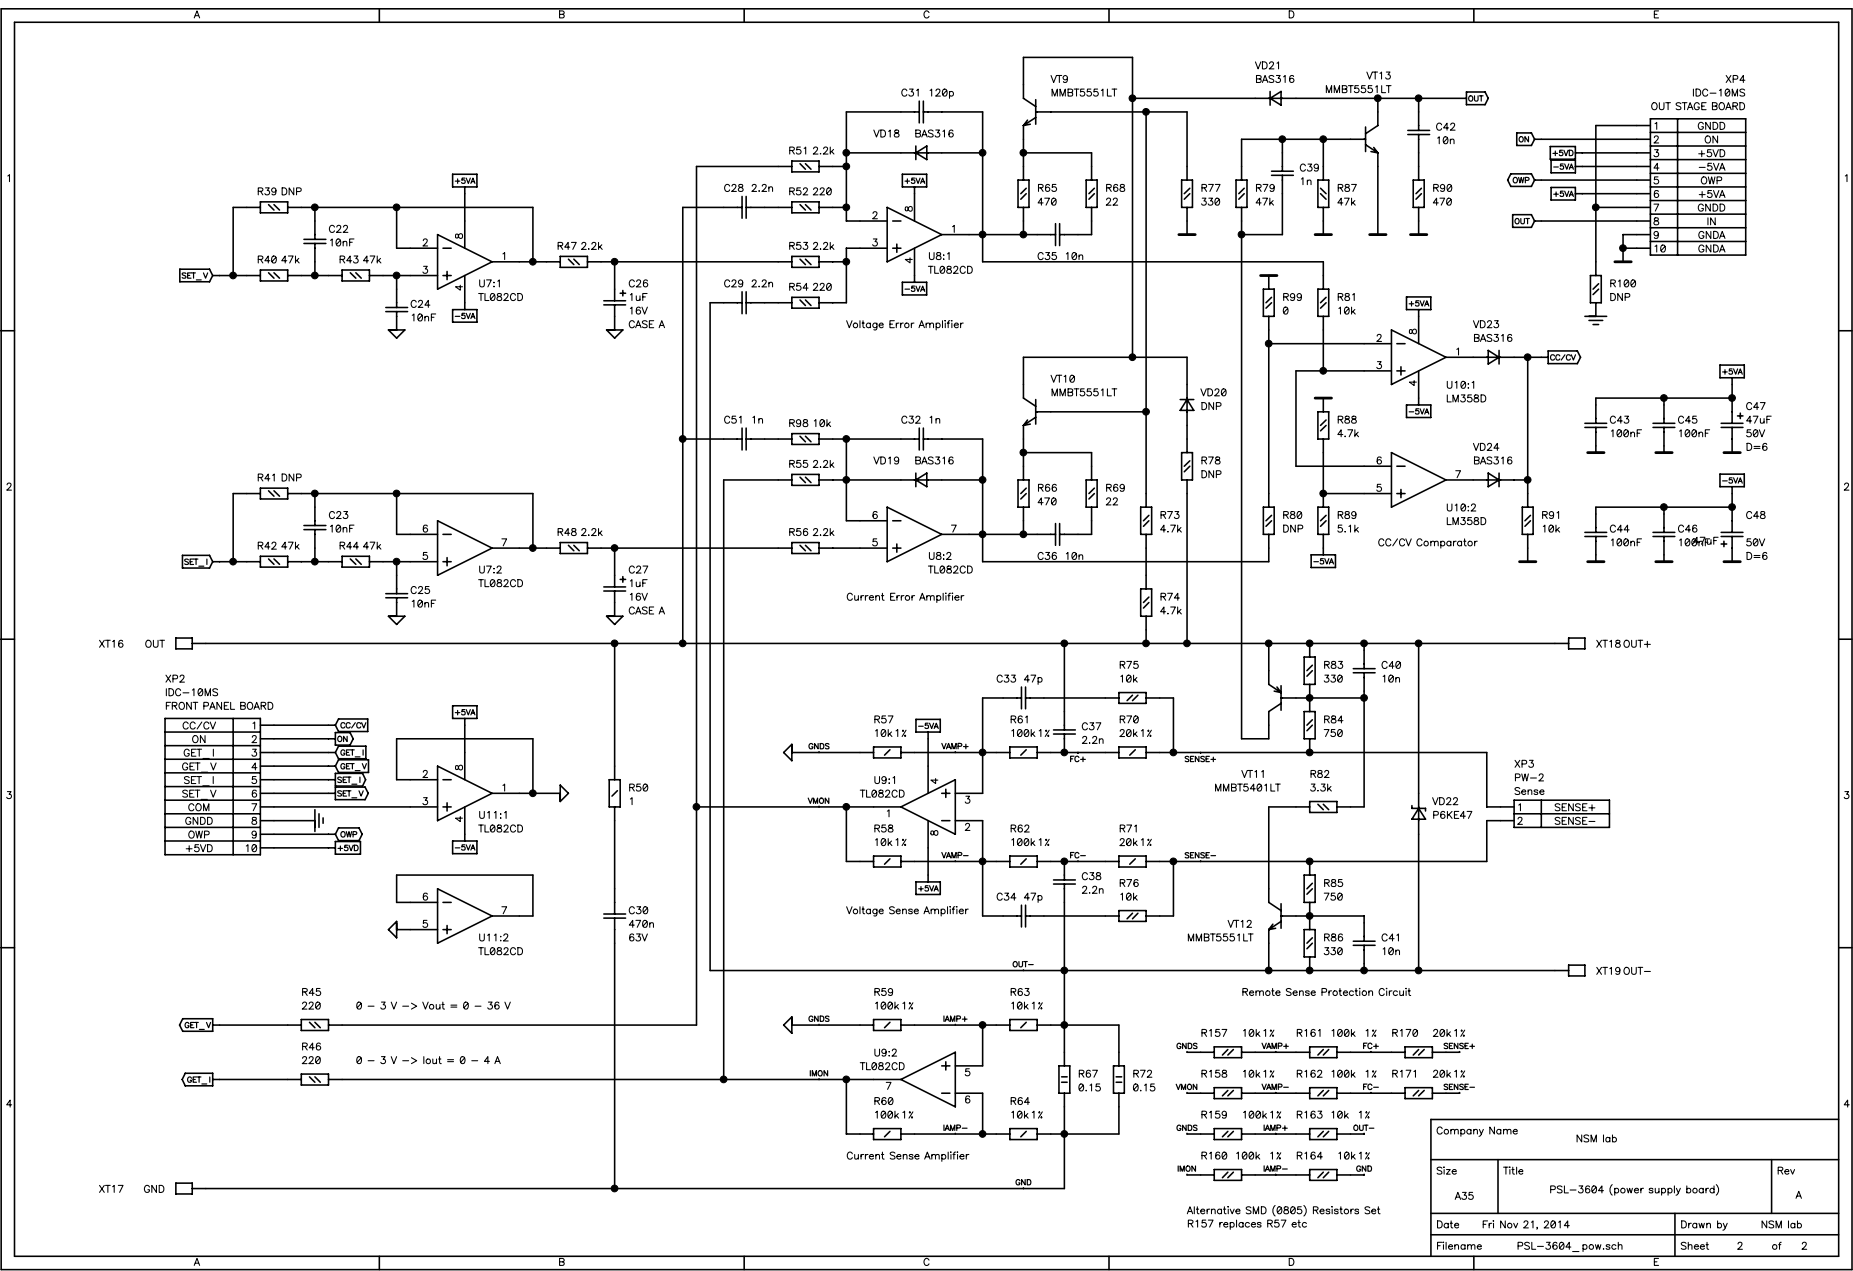
[picture p108: page 5]

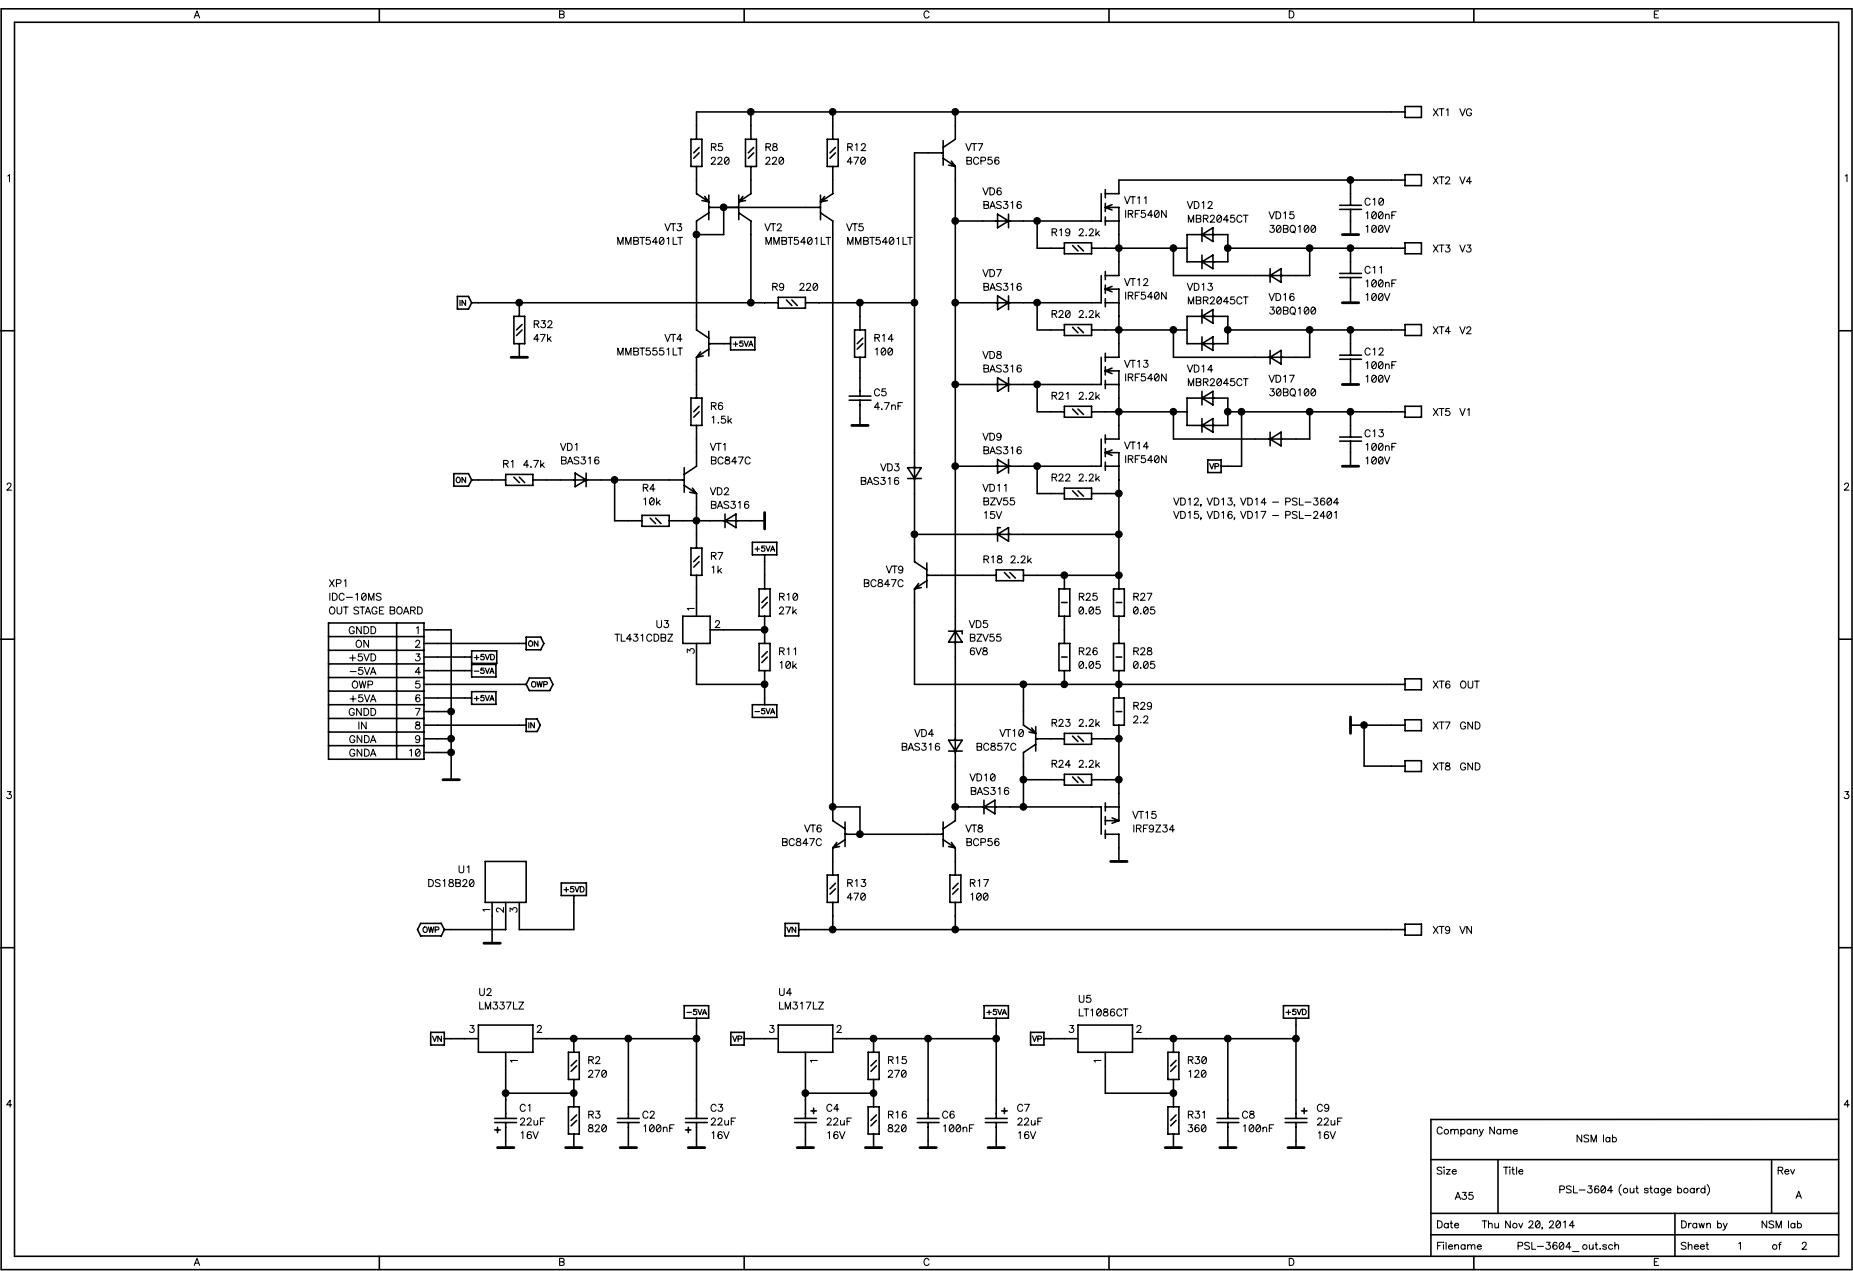
[picture p109: page 6]

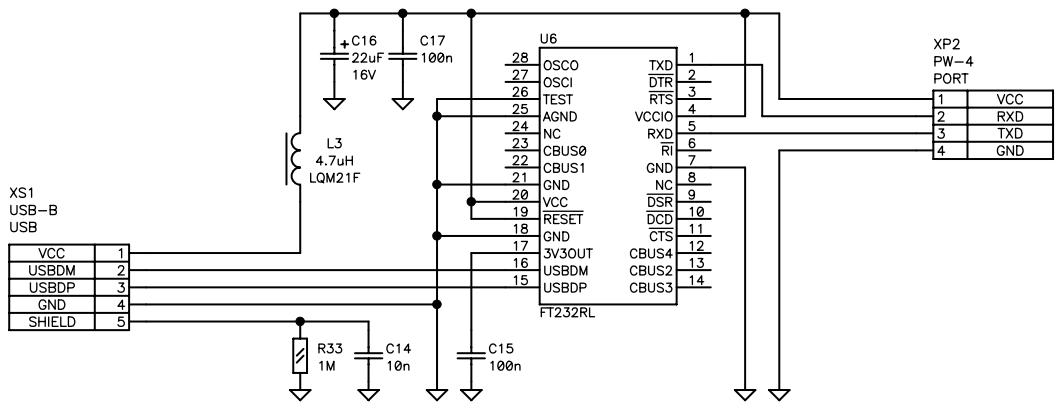
[picture p110: page 7]
