diyaudioby/psl-3604/(list of files, drawings)

Other design files:
pcb/out/PSL-3604_out.pcb
pcb/out/PSL-3604_out_usb.pcb
pcb/out/PSL-3604_usb.pcb
pcb/pan/PSL-3604_pan.pcb
pcb/pan/PSL-3604_pan_SB5_SB7.pcb
pcb/pan/PSL-3604_SB5.pcb
pcb/pan/PSL-3604_SB7.pcb
pcb/pow/PSL-3604_pow.pcb
pcb/PSL-3604_out.pcb
pcb/PSL-3604_pan.pcb
