diyaudioby/psl-3604/source/Source/fan.cpp

//----------------------------------------------------------------------------

//Модуль управления вентилятором

//----------------------- Используемые ресурсы: ------------------------------

//Вентилятор через ключевой каскад (транзистор, диод, дроссель, конденсатор)
//подключен к порту PB14 (выход таймера TIM15 CH1). Активный уровень - ВЫСОКИЙ.
//Частота ШИМ устанавливается максимально возможной, чтобы в как можно большем
//диапазоне регулировки обеспечить неразрывный ток дросселя.
//Для управления используются градации ШИМ от 0 до 100, что соответствует
//скорости вращения от 0 до 100%. Ключевой каскад питается от напряжения V2,
//которое обычно выше номинального напряжения двигателя вентилятора. Поэтому
//общее число градаций ШИМ выбирается таким образом, чтобы 100-я градация
//соответствовала номинальному напряжению вентилятора FAN_V_MAX.

//----------------------------------------------------------------------------

#include "main.h"
#include "fan.h"
#include "data.h"
#include "therm.h"

//------------------------------- Константы: ---------------------------------

#define V2        22.5 //уровень напряжения V2, В
#define FAN_MAX_V 12.0 //максимальное напряжение питания вентилятора, В
#define FAN_MAX_PWM ((uint16_t)(FAN_MAX_SPEED * V2 / FAN_MAX_V))

enum { FAN_OFF, FAN_RUN }; //состояния вентилятора

//----------------------------------------------------------------------------
//------------------------------ Класс TFan: ---------------------------------
//----------------------------------------------------------------------------

//----------------------------- Конструктор: ---------------------------------

TFan::TFan(void)
{
  RCC->APB2ENR |= RCC_APB2ENR_TIM15EN;   //включение тактирования TIM15
  TIM15->PSC = 0;                        //прескалер
  TIM15->ARR = FAN_MAX_PWM;              //период
  TIM15->CCR1 = 0;                       //код PWM
  TIM15->CCMR1 =
    TIM_CCMR1_OC1M_0 * 6 |               //PWM mode 1
    TIM_CCMR1_OC1PE  * 1;                //CCR1 preload enable
  TIM15->CCER =
    TIM_CCER_CC1P    * 0 |               //high active
    TIM_CCER_CC1E    * 1;                //OC1 enable
  TIM15->EGR = TIM_EGR_UG;               //update regs from shadow regs
  TIM15->BDTR = TIM_BDTR_MOE;            //main output enable
  TIM15->CR1 = TIM_CR1_CEN;              //разрешение таймера

  AFIO->MAPR2 |= AFIO_MAPR2_TIM15_REMAP; //remap TIM15
  Pin_FAN.Init(AF_PP_10M);               //настройка пина
  RunTimer = 0;
  SetSpeed(0);
  State = FAN_OFF;
}

//------------------------ Управление вентилятором: --------------------------

void TFan::Control(int16_t tl, int16_t th, int16_t tget)
{
  //проверка аварийных ситуаций:
  if(th == TEMP_FAIL || tget == TEMP_FAIL)
  {
    Speed = FAN_MAX_SPEED;
  }
  //пропорциональное управление:
  else if(tl < th)
  {
    if(tget > th) Speed = FAN_MAX_SPEED;
    else if(tget < tl) Speed = 0;
    else Speed = FAN_MIN_SPEED + (int32_t)(tget - tl) * (FAN_MAX_SPEED - FAN_MIN_SPEED) / (th - tl);
  }
  //релейное управление с гистерезисом:
  else
  {
    if(tget > tl) Speed = FAN_MAX_SPEED;
    else if(tget < th) Speed = 0;
  }

  switch(State)
  {
  case FAN_OFF:
    {
      if(Speed > FAN_MIN_SPEED)
      {
        Speed = FAN_STARTUP_SPEED;
        State = FAN_RUN;
        RunTimer = FAN_MIN_RUN;
      }
      else
      {
        Speed = 0;
      }
      break;
    }
  case FAN_RUN:
    {
      if(RunTimer)
      {
        RunTimer--;
        if(Speed < FAN_MIN_SPEED)
          Speed = FAN_MIN_SPEED;
      }
      else
      {
        if(Speed < FAN_MIN_SPEED)
        {
          Speed = 0;
          State = FAN_OFF;
        }
      }
      break;
    }
  }
  SetSpeed(Speed);
}

//-------------------- Установка скорости вентилятора: -----------------------

void TFan::SetSpeed(uint8_t p)
{
  if(p > FAN_MAX_SPEED) p = FAN_MAX_SPEED;
  Speed = p;
  TIM15->CCR1 = p;
}

//--------------------- Чтение скорости вентилятора: -------------------------

uint8_t TFan::GetSpeed(void)
{
  return(Speed);
}

//----------------------------------------------------------------------------
//----------------------------------------------------------------------------
//----------------------------------------------------------------------------
