diyaudioby/psl-3604/(commit log)

2019-11-27 add new BOM
    [psl-3604-bom.xlsx]
2020-01-21 change links for pcb order
2021-10-07 separate pcb and add gerbers for each pcb
    [PSL-3604_SB5.pcb, PSL-3604_SB7.pcb, PSL-3604_out.pcb, PSL-3604_out_usb.pcb, PSL-3604_out_usb.sch, PSL-3604_pan.pcb, PSL-3604_pan.sch, PSL-3604_pan_SB5_SB7.pcb]
